omelia-iliffe/Arduino-Printing-Calc/Docs/img/IMG_0253.jpg

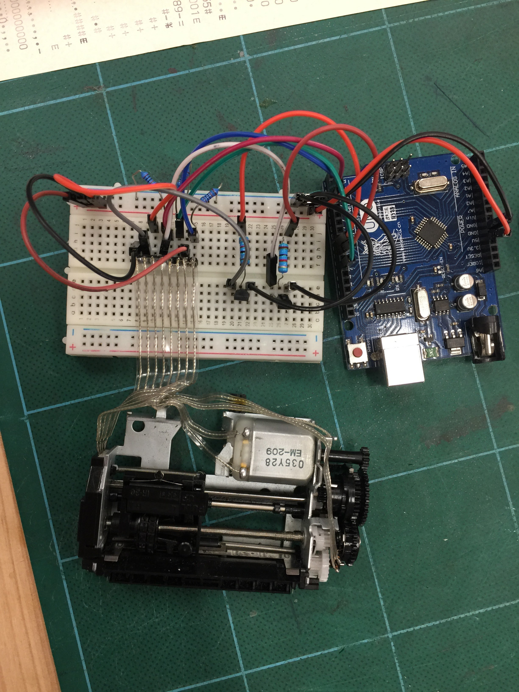
Docs/img/IMG_0253.jpg
