omelia-iliffe/Arduino-Printing-Calc/Docs/img/IMG_0254.jpg

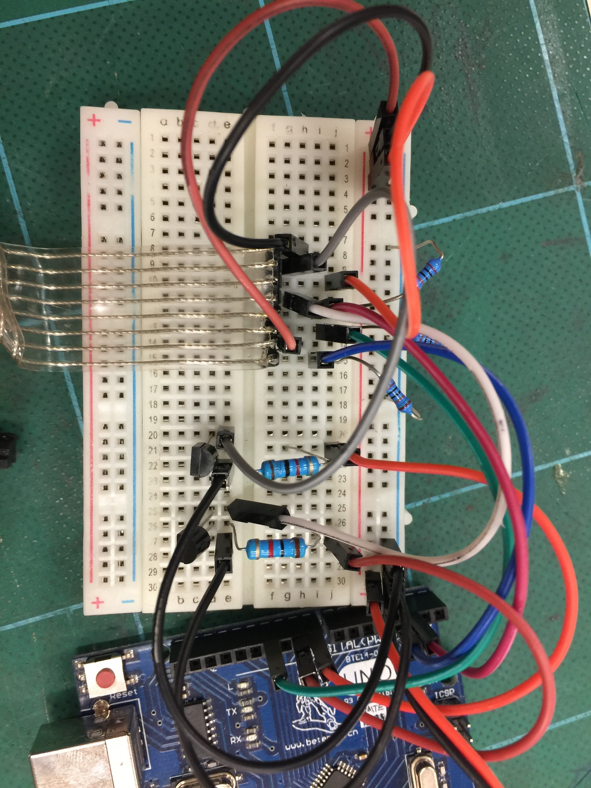
Docs/img/IMG_0254.jpg
