omelia-iliffe/Arduino-Printing-Calc/Docs/img/IMG_0255.jpg

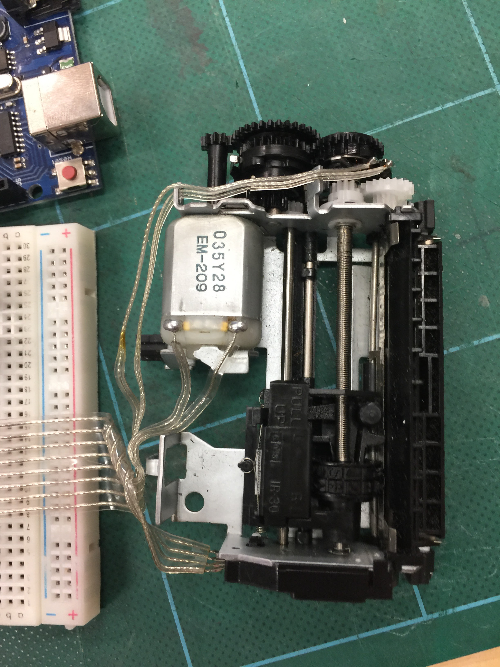
Docs/img/IMG_0255.jpg
