omelia-iliffe/Arduino-Printing-Calc/Docs/img/IMG_0318.jpg

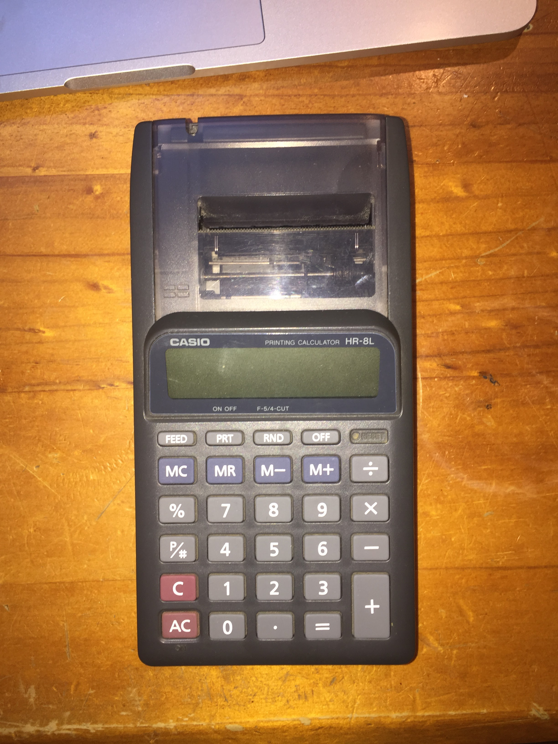
Docs/img/IMG_0318.jpg
