omelia-iliffe/Arduino-Printing-Calc/Docs/img/IMG_0321.jpg

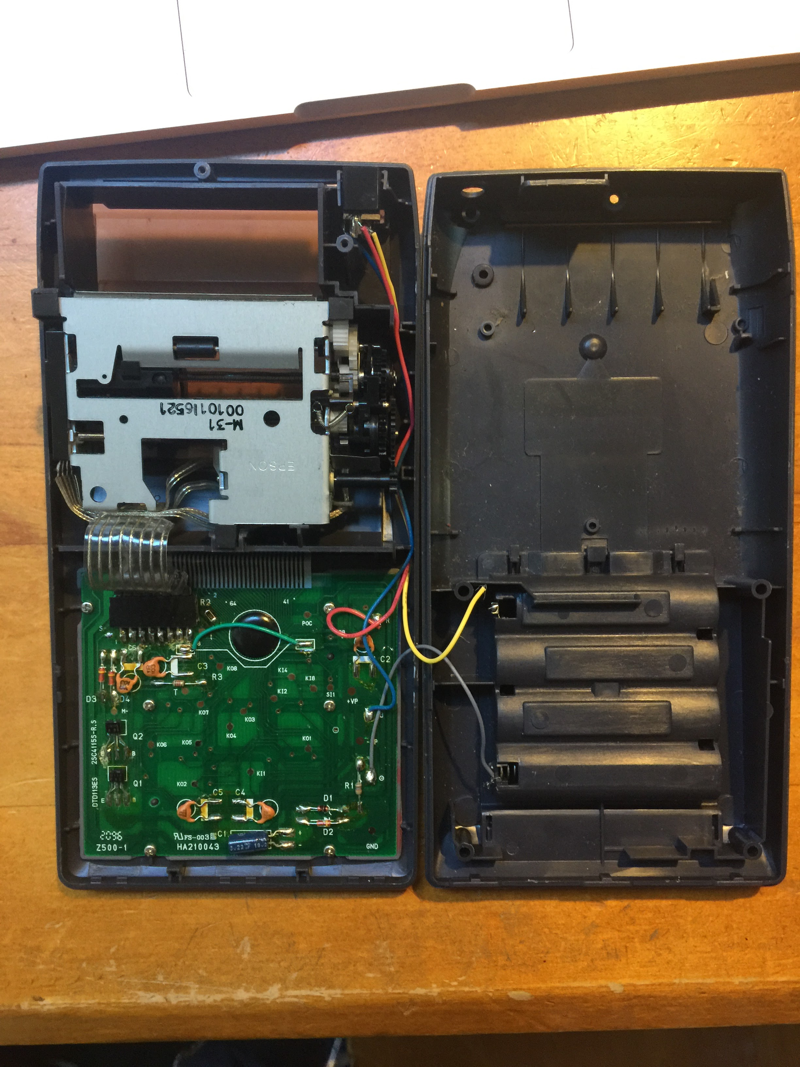
Docs/img/IMG_0321.jpg
