omelia-iliffe/Arduino-Printing-Calc/Docs/img/IMG_0322.jpg

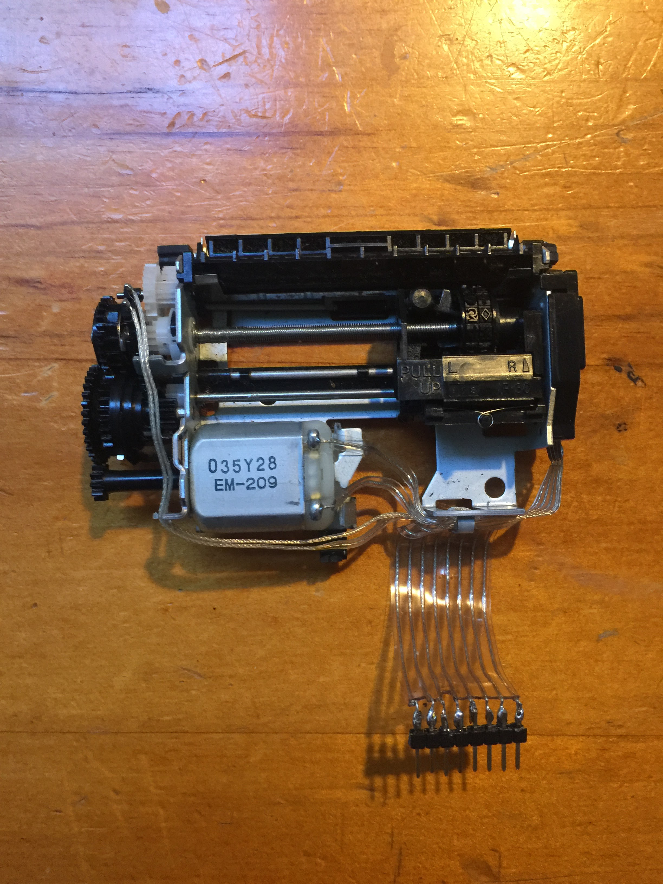
Docs/img/IMG_0322.jpg
