omelia-iliffe/Arduino-Printing-Calc/Code/bitmaps.h

#include <avr/pgmspace.h>

const String greeting[] PROGMEM = {
  "01134 ",
  "00000 "
};

const String bitmap1[] PROGMEM = {
  "0000000000000", 
  "0000000000000", 
  "0000000000000", 
  "......0......", 
  "......0......", 
  "......0......", 
  "......0......", 
  "......0......", 
  "......0......", 
  "0000000000000", 
  "0000000000000", 
  ".............", 
  "0000000000000", 
  "0000000000000", 
  "0.....0.....0", 
  "0.....0.....0", 
  "0.....0.....0", 
  "0.....0.....0", 
  "0.....0.....0", 
  ".............", 
  ".............", 
  "0000000000000", 
  "0000000000000", 
  "0............", 
  "0............", 
  "0............", 
  "0............", 
  "0............", 
  ".............", 
  "0000000000000", 
  "0000000000000", 
  "0............", 
  "0............", 
  "0............", 
  "0............", 
  "0............", 
  ".............", 
  "....00000....", 
  "..000000000..", 
  ".00.......00.", 
  "00.........00", 
  "0...........0", 
  "0...........0", 
  "0...........0", 
  "00.........00", 
  ".00.......00.", 
  "..000000000..", 
  "....00000...."
};
  
const String bitmap2[] PROGMEM = {
  ".............",
  ".00000000000.",
  "......0......",
  "......0......",
  "......0......",
  ".00000000000.",
  ".............",
  ".............",
  ".00000000000.",
  ".0....0....0.",
  ".0....0....0.",
  ".0....0....0.",
  ".............",
  ".00000000000.",
  ".0...........",
  ".0...........",
  ".0...........",
  ".............",
  ".00000000000.",
  ".0...........",
  ".0...........",
  ".0...........",
  "....00000....",
  "..00.....00..",
  ".0.........0.",
  ".0.........0.",
  ".0.........0.",
  "..00.....00..",
  "....00000....",
  "............."
};
